LeaJacobsen/beehive-datalogger/DataAnalyse.docx

9. December:

Vores datalogger er sat til d. 9. december omkring klokken 18. Den højeste middelværdi for temperaturen er 11,9 C◦ inde i kassen og 10,4 udenfor. Luftfugtigheden uden for kassen er på 100 %, så det regner. Fugtigheden indenfor er 92,7 % på sit højeste og det mindste er 80,5 %. Da solen er gået ned og kassen står væk fra en lyskilde, er der ingen data fra lyssensoren.

10. december

Denne dag bød på en fortsættelse af tendensen fra tidligere, temperaturen inde i ’bikuben’ er højest af de to, og ligger på 11,4 C og 10,1 C i sit laveste. Uden for ’bikuben’ er det højeste 10,6 C og det laveste er på 9,6. Luftfugtigheden udenfor tyder stadig på regn, og inde i bikuben er det fortsat lavere luftfugtighed i forhold til udenfor. Der sker en stigning i luftfugtighed i løbet af dagen. Dette kunne have noget at gøre med bikubens opsætning og det håndklæde vi har lagt mellem vores to kasser.

Vores lyssensor har haft chancen for at opfange lys, og fra omkring 8.00 til 18.00, har data. Dette passer meget godt sammen med, at solen er stået op. Klokken 22-23 får vi dog en høj måling på lyssensoren på 23,25. Dette er fordi der er brugt en lommelygte for at tjekket dataloggeren. Ser man bort fra dette, har sensoren registreret lys fra klokken cirka 8.30 til 15.30, det er 7 timer med nok lys til at blive registreret. Det ville næppe opfattes som solskin. Denne dag havde dataloggeren ingen data fra klokken 23-00, vi er usikre på hvorfor.

11. december

Data fra denne dag følger den samme tendens som de foregående. Temperaturen inden i kassen er mellem 9,8 og 8,9 C, hvor den udenfor er mellem 9,4 og 8,3 C. Fugtigheden udenfor kassen lægger stadig op til regn det meste af tiden. Vi har ikke længere en høj luftfugtighed i løbet af dagen, vi tænker at dette kan være fordi vi har fjernet håndklædet. Det suger dermed ikke fugten til sig inde i kassen. Lyssensoren registrer lys i dagstiden, der har været lys cirka fra klokken 8.30 til 15.50. Det er 7 timer og 20 minutter med lys, men på intet tidspunkt er det solskin.

12 December

Dataloggeren bliver taget ned klokken 9, derfor er der ikke mere data efter dette tidspunkt. Der er en maks temperatur på 9,48 indenfor og 9,10 C udenfor. Minimum ligger på 8,9 indenfor og 8,5 udenfor. Temperaturerne indeni og udenfor kassen ligger meget tæt på hinanden. Luftfugtigheden ligger stabilt på de cirka 90 procent. Der er ingen data på lys, da solen endnu ikke er stået op.
